Doplers/pal-coder/pal-coder-assembled.jpg

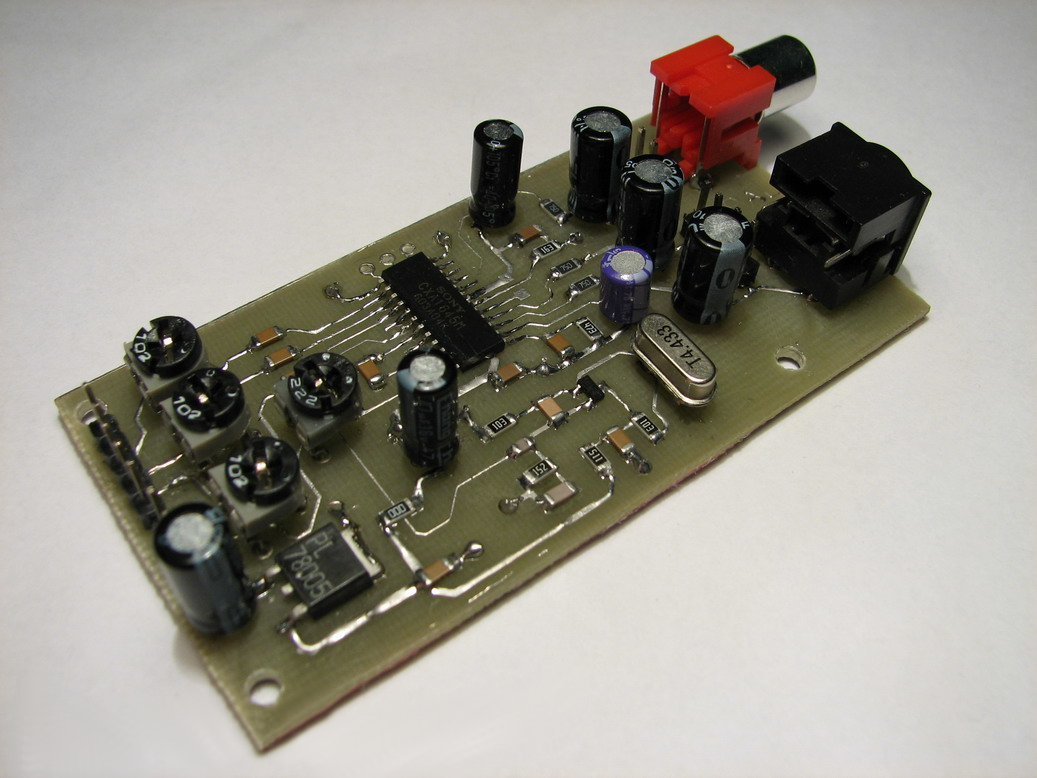
pal-coder-assembled.jpg
