Doplers/pal-coder/coderC.jpg

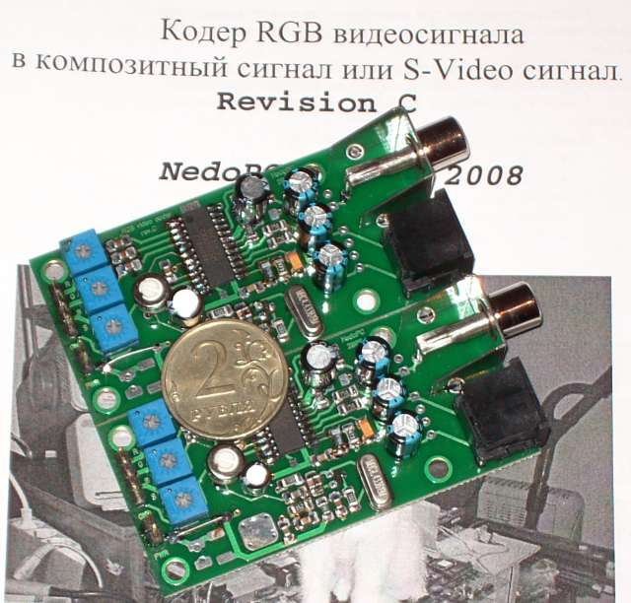
coderC.jpg
