Doplers/pal-coder/README.md

вся информация о pal-coder для nissan primera p12 плата с реле для переключения между бортовым и андроид.

ссылка на статью https://www.drive2.ru/l/652393301269294726/
