Doplers/pal-coder/12d8b8s-960.jpg

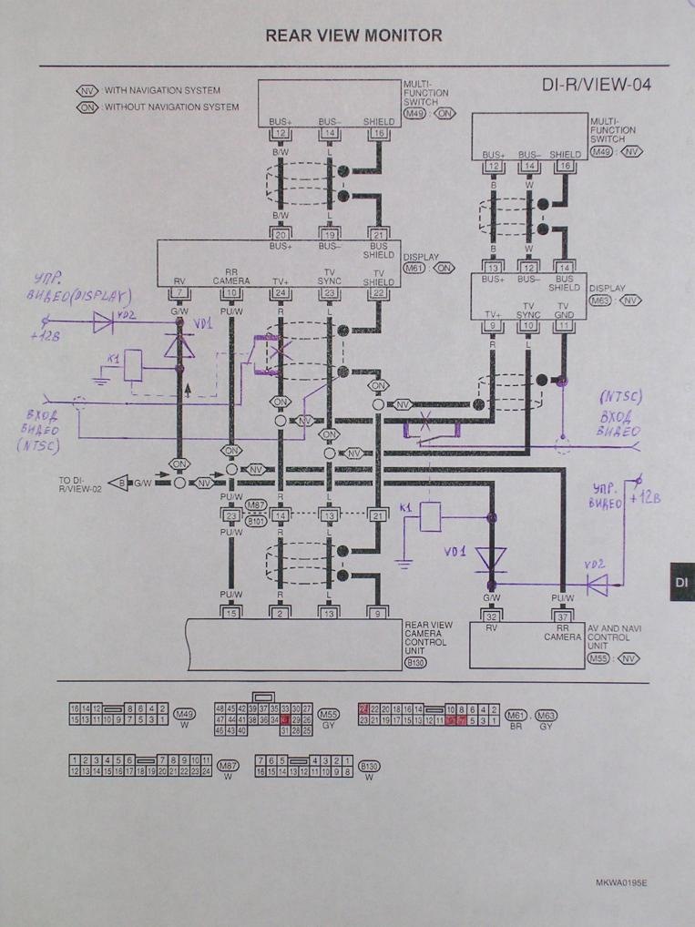
12d8b8s-960.jpg
