Doplers/pal-coder/90e6b1cs-960.jpg

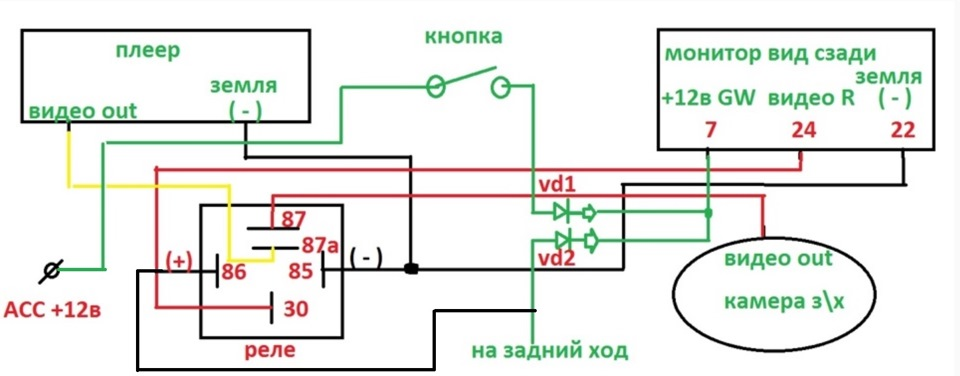
90e6b1cs-960.jpg
