Doplers/pal-coder/cfcd4.jpg

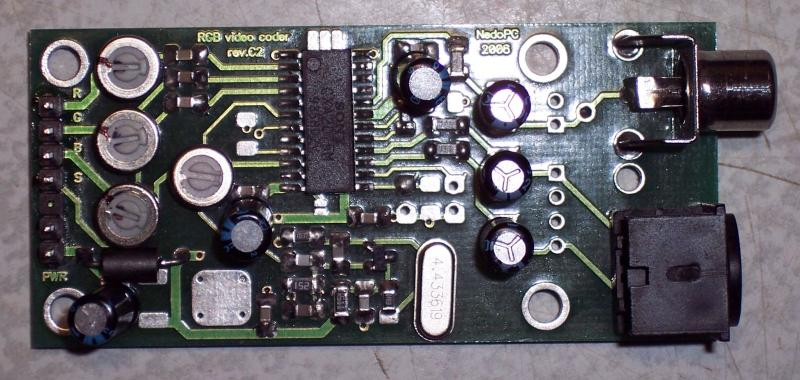
cfcd4.jpg
