Doplers/pal-coder/hr0yz92RhcoGOM9panDhboKCkQc-960.jpg

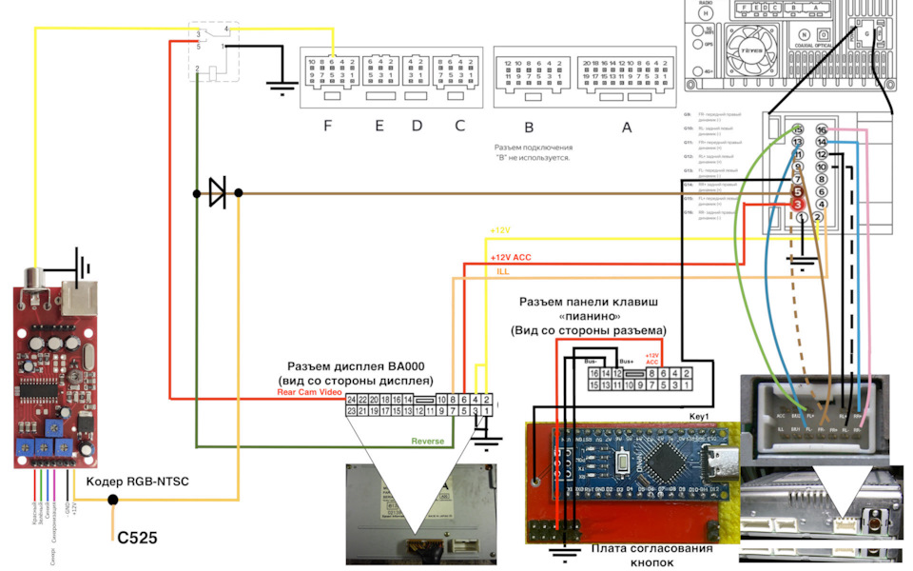
hr0yz92RhcoGOM9panDhboKCkQc-960.jpg
