Doplers/pal-coder/pal-coder-smd-layout.png

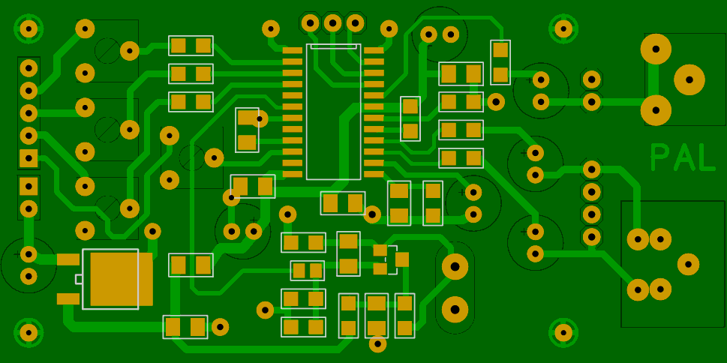
pal-coder-smd-layout.png
