Doplers/pal-coder/palcb.jpg

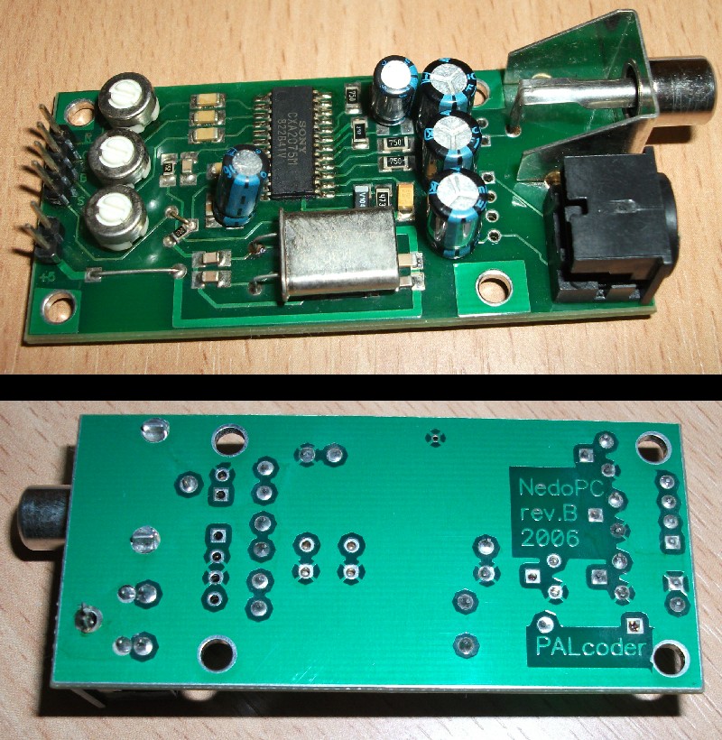
palcb.jpg
