Doplers/pal-coder/palcoder-th-layout.png

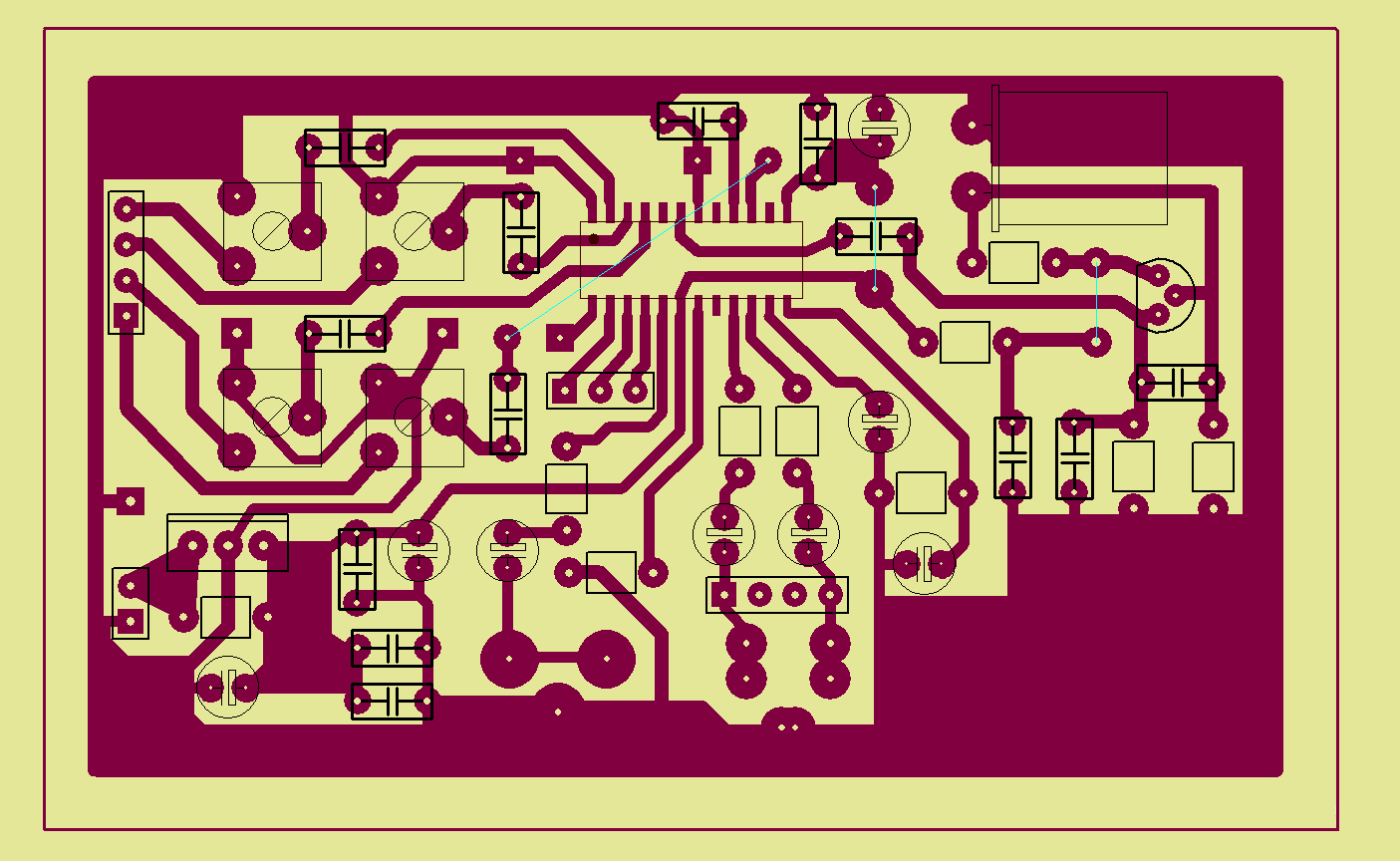
palcoder-th-layout.png
