Doplers/pal-coder/shema-cxa1145.jpg

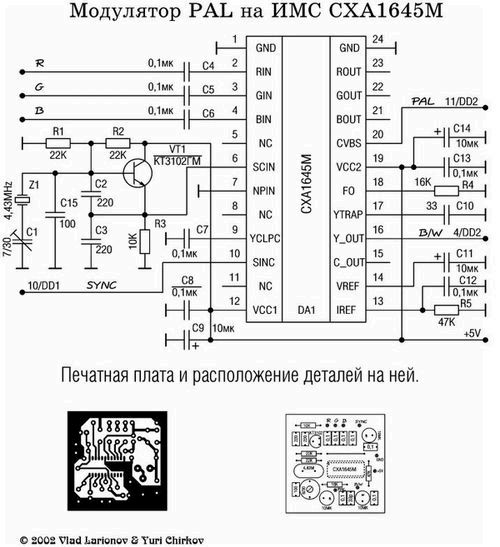
shema-cxa1145.jpg
