Doplers/pal-coder/(list of files, drawings)

Other design files:
PAL-Coder-SMD.lay6
